mlorentedev/vicon-fpga-face-detection/DOC/TFM_VICON.pptx.pdf

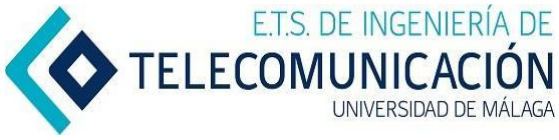
[picture p59: figure]

# Sistema de Visión Configurable

### Trabajo Final del Máster en Sistemas Electrónicos para Entornos Inteligentes

### Manuel Lorente Almán

14 de octubre de 2021

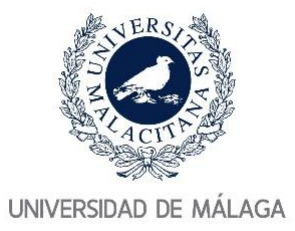
[picture p60: figure]

# Objetivo y motivación

- En los próximos 25 minutos verán del diseño hardware de una videocámara, a partir de un sensor de imagen, y de una aplicación software para la captura de imágenes y reconocimiento de rostros en tiempo real.
- Tras la presentación serán capaces de entender posibles aplicaciones del sistema:
- Identificación de personas en aeropuertos u hoteles.
- Sistema de acceso de propósito general.
- El objetivo del sistema VICON es ser un producto modular, portable y de código abierto, para acelerar el proceso de integración en sistemas más complejos.
Sistema de Visión Configurable – Manuel Lorente Almán | 2

# Contexto del proyecto

## Requisitos principales

El sistema debe ser capaz de…
❑ Adquirir imágenes en escala de grises.
❑ Adquirir imágenes al menos en formato VGA (640x480).
❑ Capturar a una tasa de al menos 10 imágenes por segundo.
❑ Adquirir imágenes sólo bajo petición del usuario.
❑ Detener y reanudar la adquisición de imágenes bajo petición del usuario. ❑ Almacenar una imagen en el ordenador imagen bajo petición del usuario. ❑ Identificar rostros que aparezcan en las imágenes bajo petición del usuario ❑ Ser autocontenido y portable para plataforma Windows.
Sistema de Visión Configurable – Manuel Lorente Almán | 3

# Arquitectura

## Vista general

Diseño hardware: sistema digital para capturar imágenes del sensor MT9V111 de Micron.
Lenguaje VHDL, IDE VIVADO 2018, interfaz UM232H-B de FTDI Chip y FPGA Artix 7 de Xilinx como herramientas principales.

Diseño software: software para visualizar imágenes del sensor, y realizar la detección de rostros.
Lenguaje C#, IDE Visual Studio 2017, y SDK .NET Framework 4.6.1 como herramientas principales.

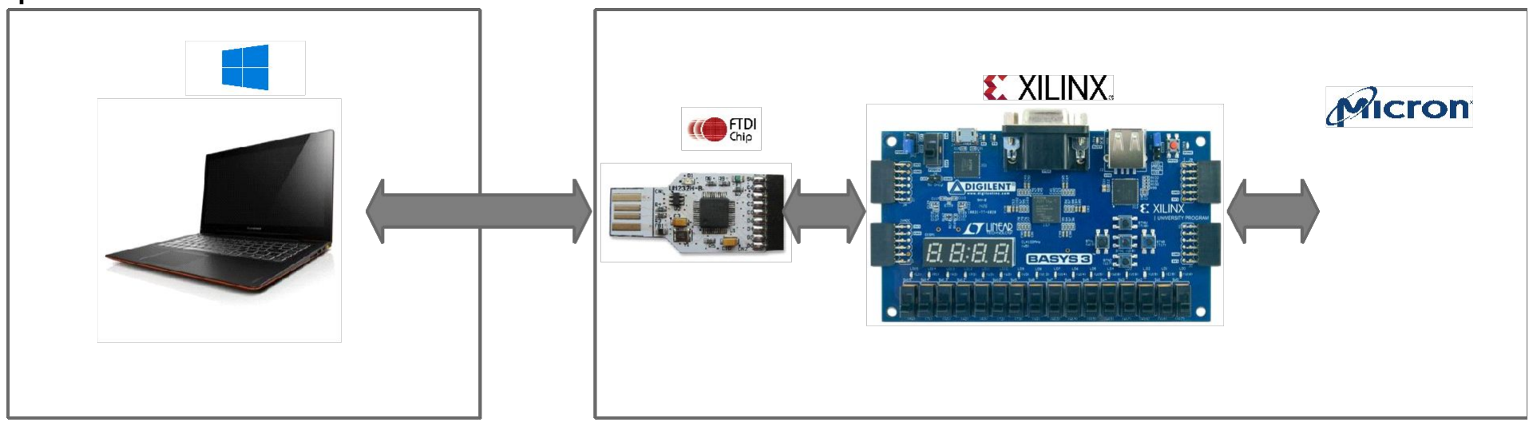
[picture p61: figure]

Sistema de Visión Configurable – Manuel Lorente Almán

# Diseño hardware

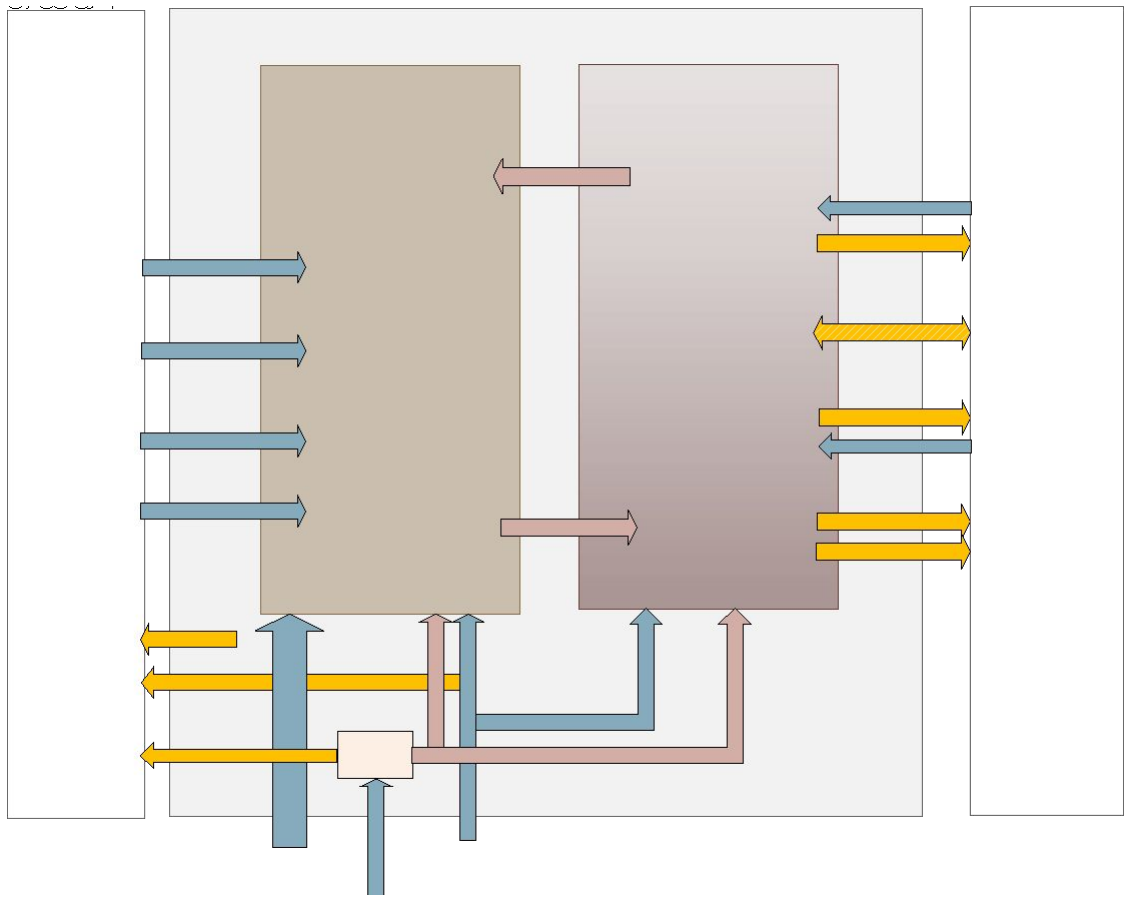
[picture p62: figure]

## Bloques principales

CGU (Clock Generation Unit)
Generación de señal de reloj del módulo sensor MT9V111.
IMAGE CHANNEL
Generación de imagen sintética emulando comportamiento del módulo sensor.
Lectura de datos del módulo sensor usando las señales de sincronización FVAL y LVAL.
FT245 CHANNEL
Envío bidireccional de datos: FPGA-PC 🡪 envío de imágenes PC-FPGA 🡪 petición de imágenes

# Diseño hardware

## CGU

Copia reloj externo para generar el reloj principal de 100 MHz para todos los bloques del sistema.

Divide el reloj externo para generar una señal periódica a 25 MHz para el módulo sensor y así obtener una tasa de aproximadamente 27 FPS en formato VGA.

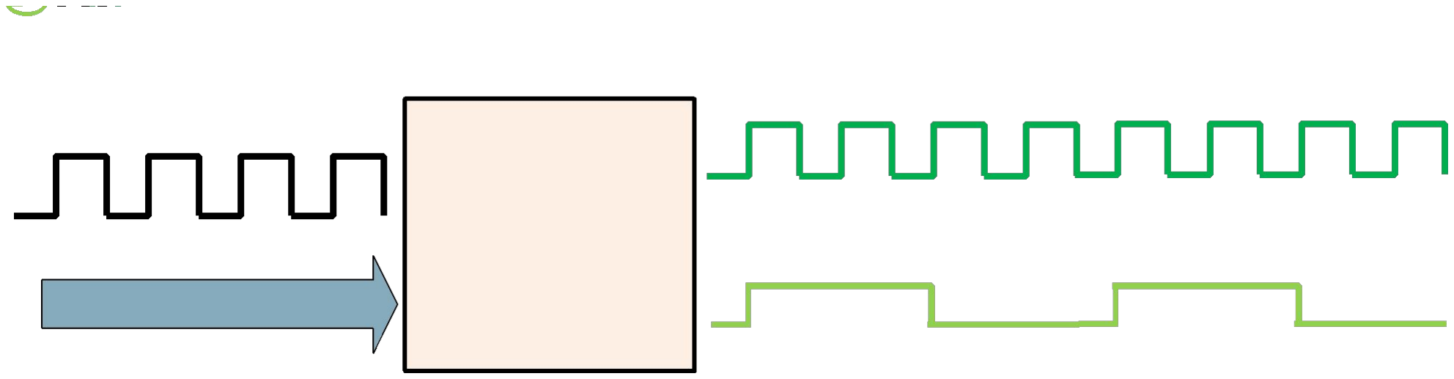
[picture p63: figure]

# Diseño hardware

## Esquema de sincronización

El sistema posee un sólo dominio de reloj (MCLK), y algunas señales externas son asíncronas como RXF# y TXE# del módulo UM232-H-B.

Es necesaria una estrategia de sincronización.

Se implementa un sincronizador de dos etapas formado por un registro de desplazamientos con dos Flip-Flops para retrasar cada señal asíncrona, y así operar siempre con señales síncronas.

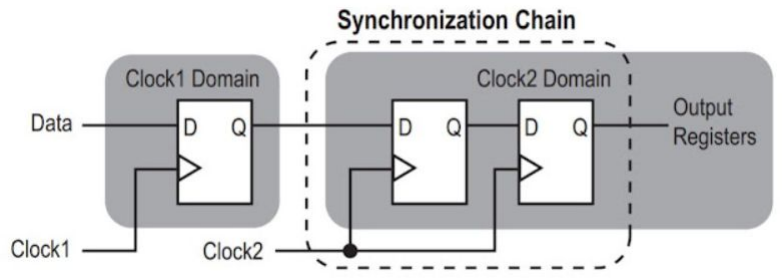
[picture p64: figure]

# Diseño hardware

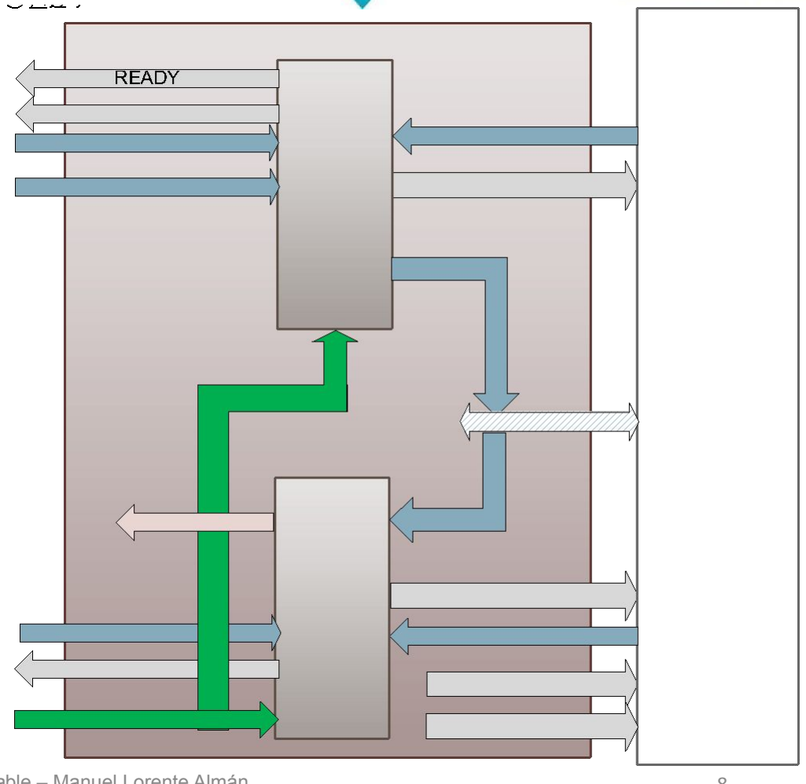
[picture p65: figure]

## FT245 CHANNEL

Activa señal REQUEST para indicar la petición de imagen tras recibir un dato desde el PC.

Gestiona la lectura de la memoria FIFO (POP).

Garantiza los tiempos de lectura y escritura en
el | dispositivo | UM232-H-B | (WR_ENA | y
RD_ENA).

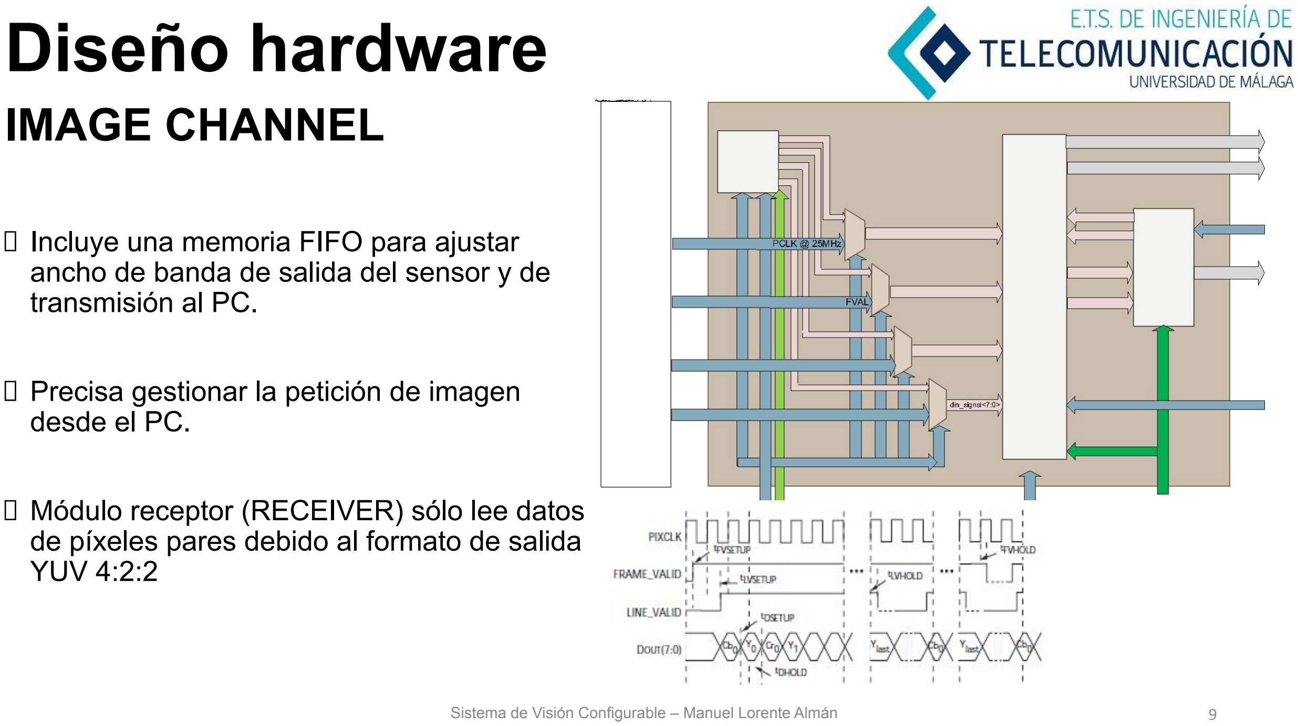
[picture p66: figure]
Diseño hardware; IMAGE CHANNEL;  Incluye una memoria FIFO para ajustar; transmisión al PC.; desde el PC.; YUV 4:2:2

ancho de banda de salida del sensor y de

Precisa gestionar la petición de imagen

Módulo receptor (RECEIVER) sólo lee datos de píxeles pares debido al formato de salida

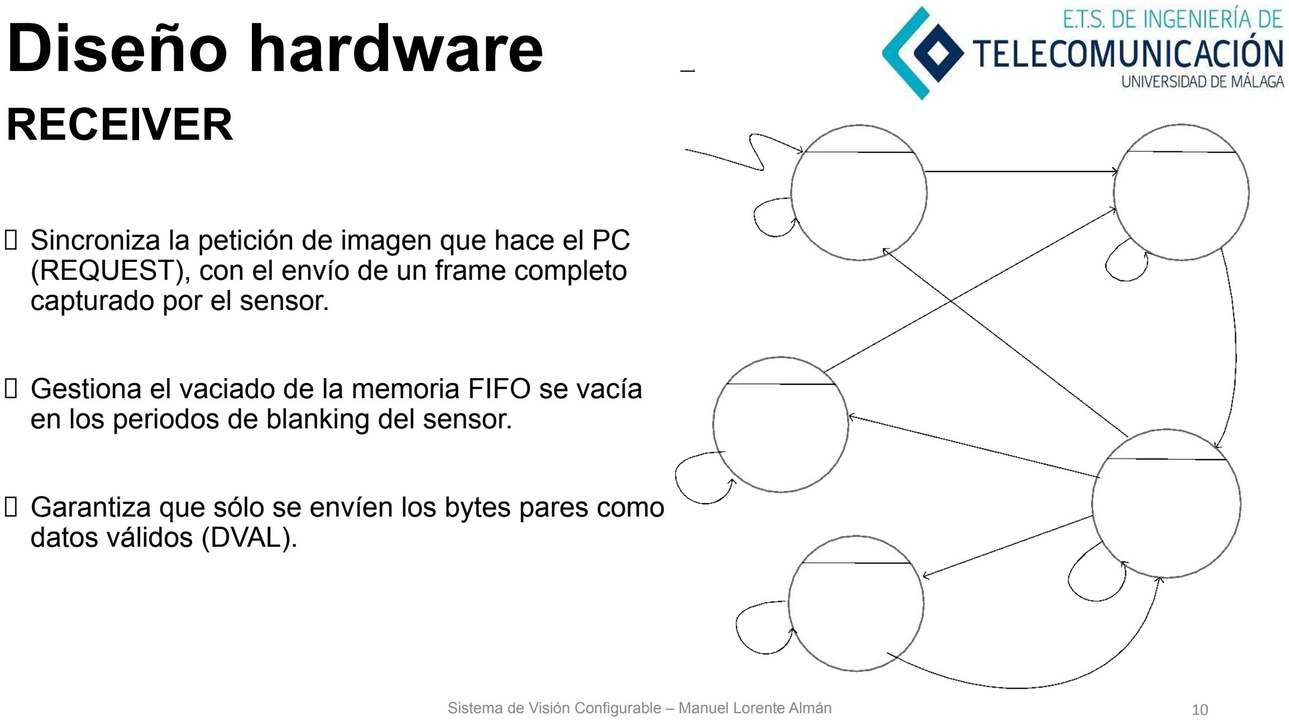
[picture p67: figure]
Diseño hardware; RECEIVER; capturado por el sensor.; en los periodos de blanking del sensor.; datos válidos (DVAL).

Sincroniza la petición de imagen que hace el PC (REQUEST), con el envío de un frame completo

Gestiona el vaciado de la memoria FIFO se vacía

Garantiza que sólo se envíen los bytes pares como

# Diseño hardware

## IMAGE PATTERN

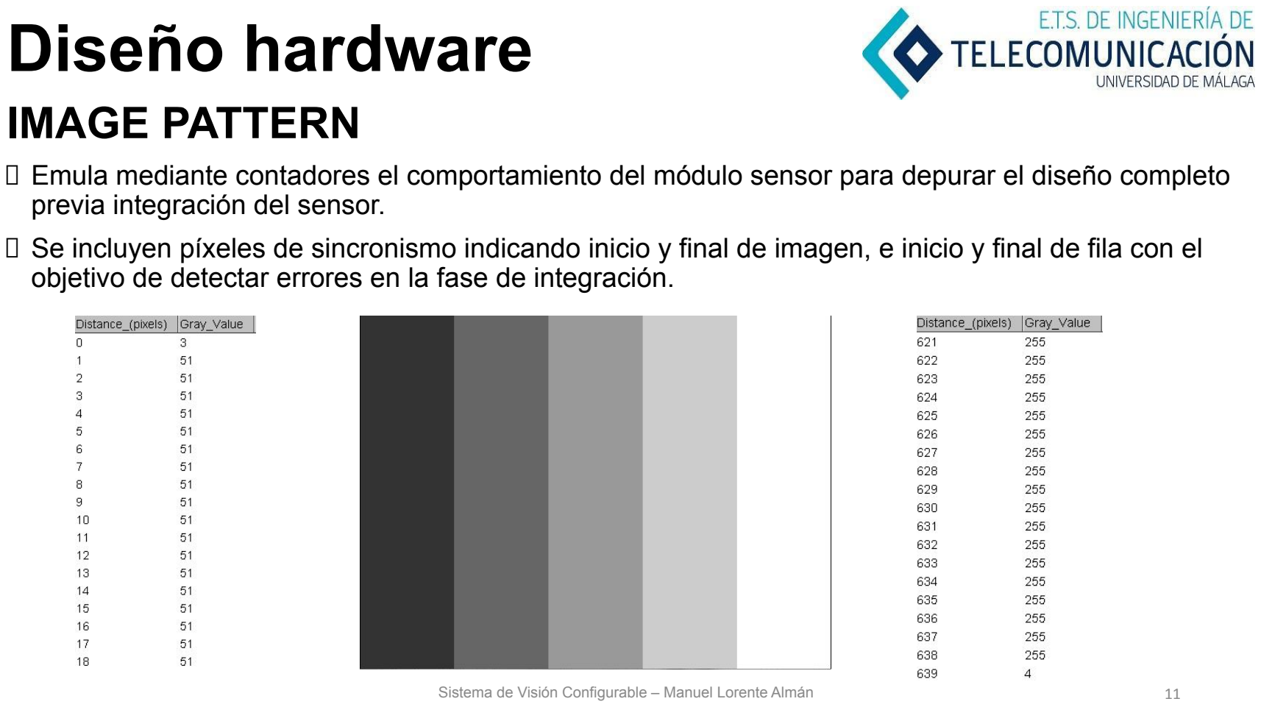
[picture p68: page 11]

Emula mediante contadores el comportamiento del módulo sensor para depurar el diseño completo previa integración del sensor.
Se incluyen píxeles de sincronismo indicando inicio y final de imagen, e inicio y final de fila con el objetivo de detectar errores en la fase de integración.

# Diseño hardware

## Simulación modular – IMAGE CHANNEL

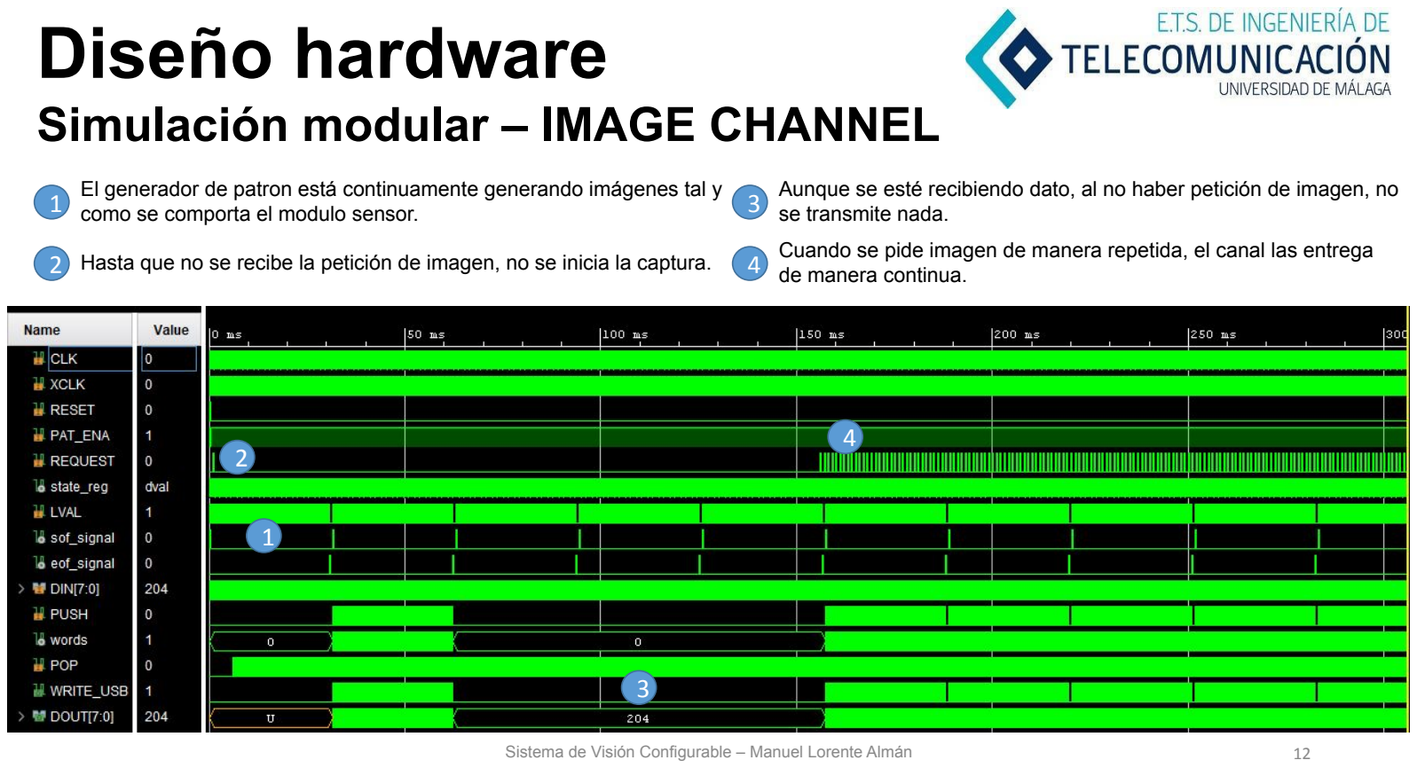
[picture p69: page 12]

Sistema de Visión Configurable – Manuel Lorente Almán | 12

1

2

3

4

1

El generador de patron está continuamente generando imágenes tal y como se comporta el modulo sensor.

2 Hasta que no se recibe la petición de imagen, no se inicia la captura.

3

Aunque se esté recibiendo dato, al no haber petición de imagen, no se transmite nada.

4

Cuando se pide imagen de manera repetida, el canal las entrega de manera continua.

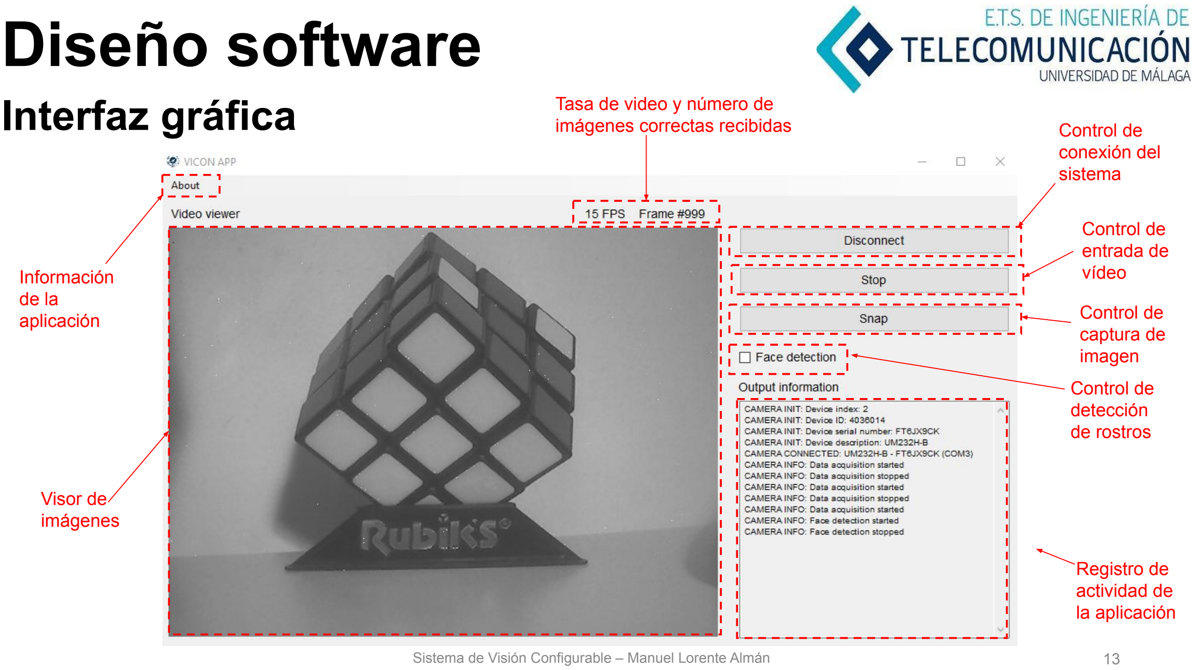
[picture p70: figure]
Diseño software; Interfaz gráfica; Visor de imágenes; Información de la aplicación; Tasa de video y número de imágenes correctas recibidas; Registro de actividad de la aplicación; Control de detección de rostros; Control de captura de imagen; Control de entrada de vídeo; Control de conexión del sistema

# Diseño software

## Lectura de datos

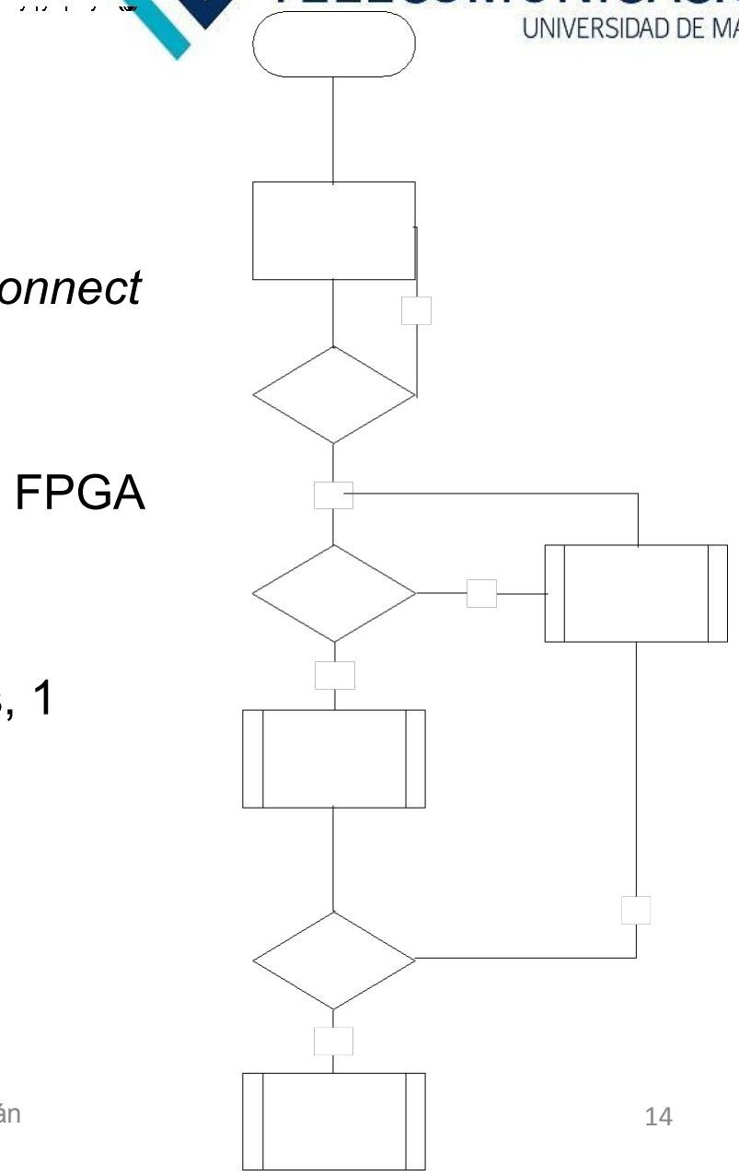
[picture p71: figure]

Hilo que espera la activación del flag fData a través del botón Connect de la interfaz gráfica.

Si no se ha solicitado imagen (flag fRead), se envía un byte a la FPGA a través dispositivo FT232H.

La imagen VGA esperada es de 307200 bytes (640x480 píxeles, 1 byte por píxel).

# Diseño software

## Procesamiento de datos

Se realiza en la propia función GUIUpdate que actualiza la interfaz gráfica con cada imagen entrante.

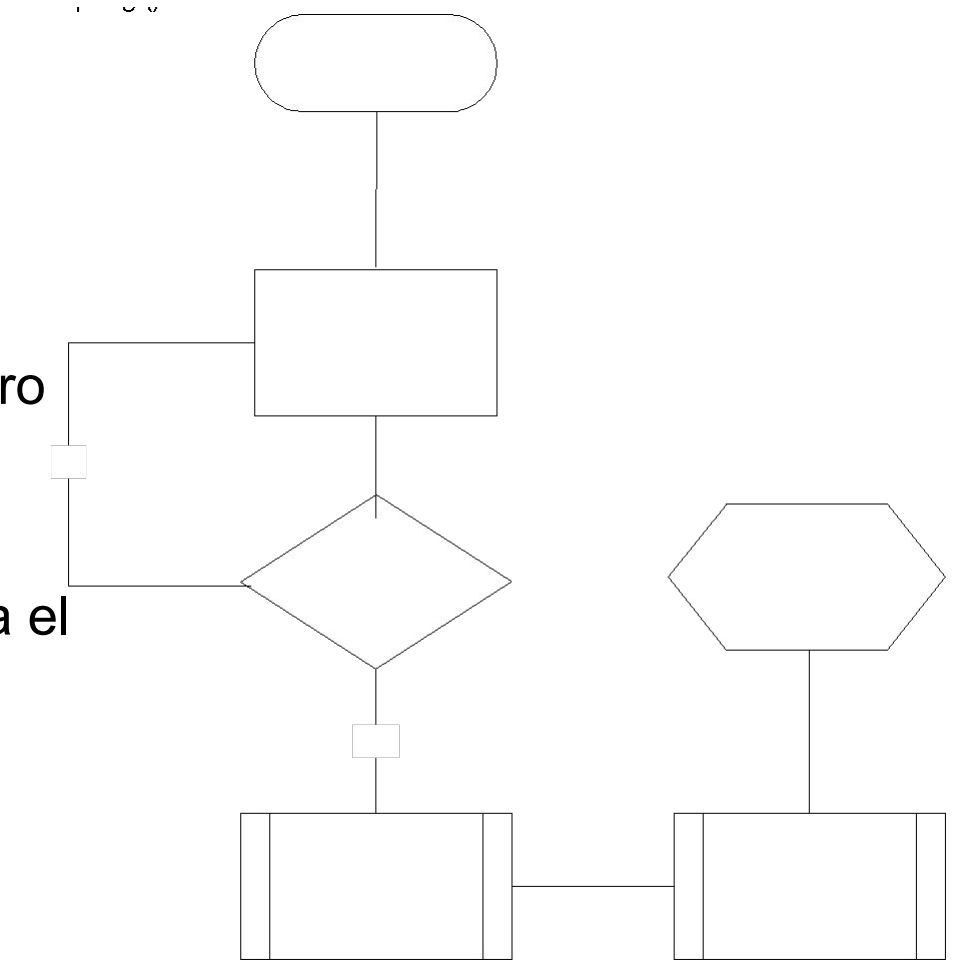
[picture p72: figure]

Proceso que calcula la tasa de imágenes recibidas y el número de imagen recibida.

Si la detección de rostros está activada (flag fFaces) se utiliza el clasificador haarcascade incluido en la librería OpenCV.

# Plan de validación

## Casos de uso

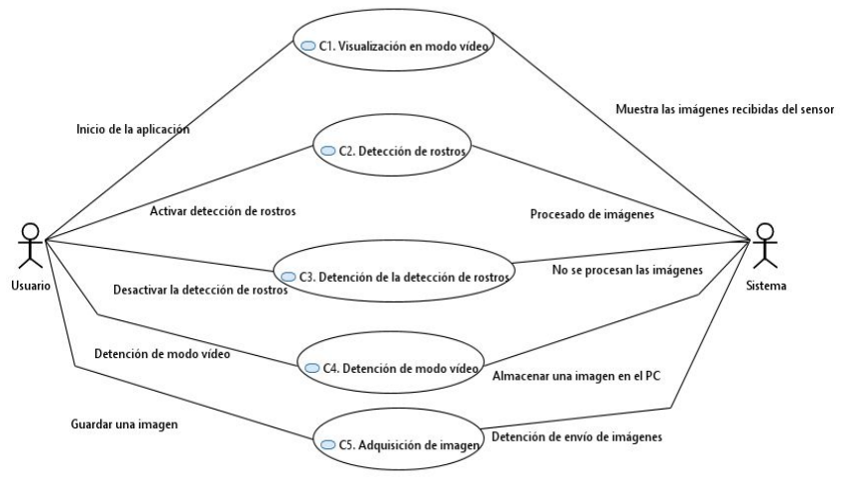
[picture p73: figure]

Sistema de Visión Configurable – Manuel Lorente Almán | 16

# Plan de validación

## Pruebas realizadas

Prueba | Descripción | | Errores
1 - Instalación | Instalar la aplicación en un ordenador con Windows 7 o posterior. | La aplicación falla, y no es posible completar la instalación. La aplicación se instala, pero no puede ejecutarse.
2 - Visualización de video | Se ejecuta la aplicación y se conecta la FPGA al PC mediante el controlador FT245. Visualización de vídeo en tiempo real | La aplicación no muestra ningún tipo de imagen por pantalla No se consigue una tasa mínima de 10 FPS. El video recibido se pixela o entrecorta.
3 - Habilitación de entrada de vídeo | Se detiene y reanuda la adquisición de imágenes. | El sistema no es capaz de reanudar o detener el vídeo. El sistema sólo detiene o reanuda el vídeo una vez, y no vuelve a hacerlo. El sistema detiene el vídeo, pero no lo reanuda con imágenes en tiempo real.
4 - Detección de rostros | Se solicita detectar los rostros frente a la cámara. | No se detecta ningún rostro a una distancia máxima de 2 metros. Los rostros no se marcan con un rectángulo completamente. Únicamente detecta un rostro, pese a haber varios.
5 - Captura de imagen | Se solicita almacenar una imagen. | El sistema genera un archivo de imagen corrupto.

# Plan de validación

## Demostración práctica

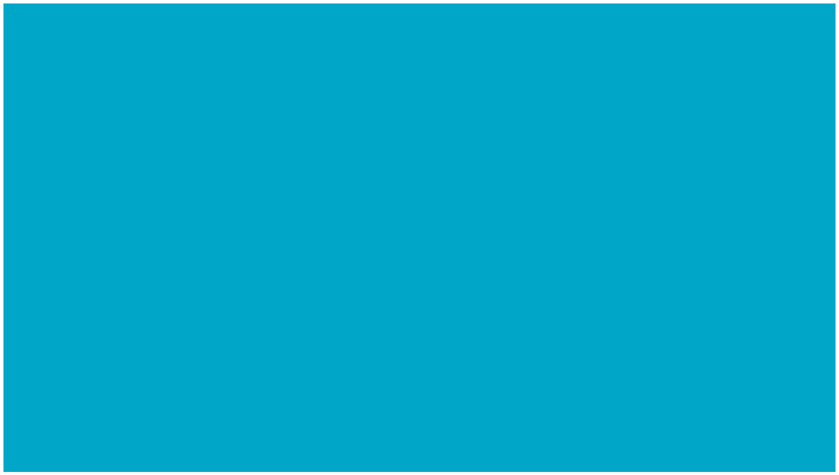
[picture p74: figure]

# Conclusiones

## Lecciones aprendidas

Utilización de memoria FIFO intermedia para ajuste de anchos de banda entre interfaces.
Necesidad de mecanismo de sincronización de entradas asíncronas al sistema.
Utilidad del generador de imágenes sintéticas como mecanismo fundamental del depurado de la videocámara.

## … y posibles mejoras

Configuración mediante I2C del módulo sensor.
Procesado de imágenes a color.
Implementación de salida física de video mediante la salida VGA de la placa BASYS3.

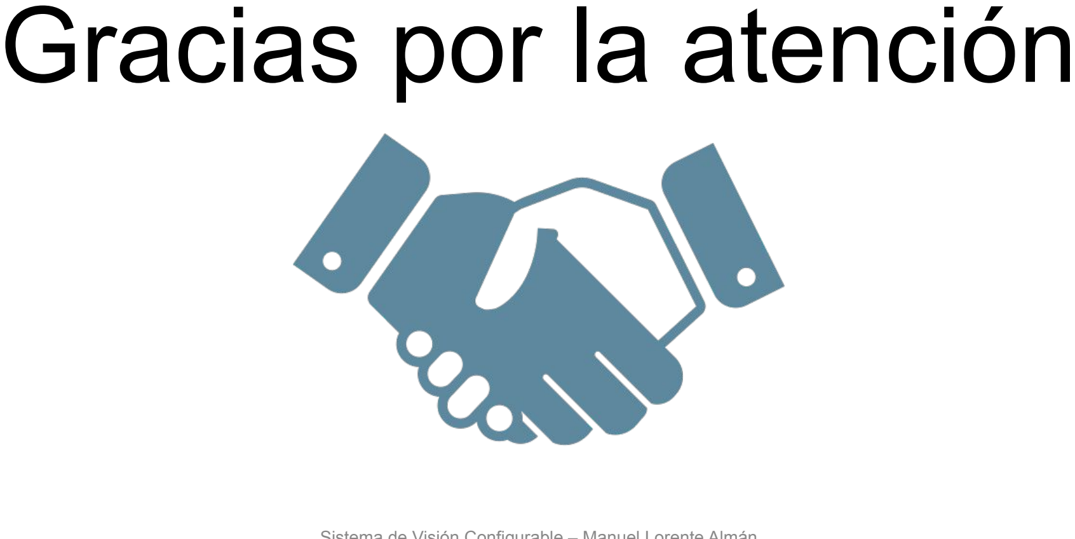
[picture p75: figure]
Gracias por la atención
